juyoung020/trolley-sensor-mount/print/front_jaw.stl

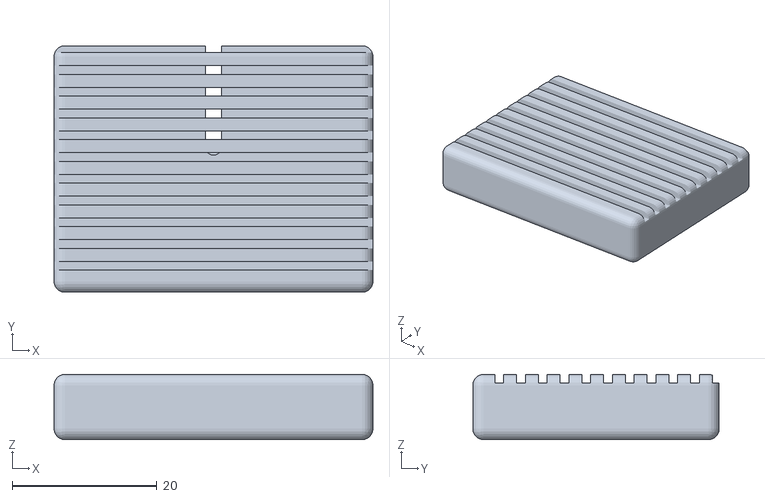
[picture p3: CAD file, 2026-11-08]
print/front_jaw.stl
44.0 x 34.0 x 9.00
