juyoung020/trolley-sensor-mount/print/trolley_mount_X2D.3mf

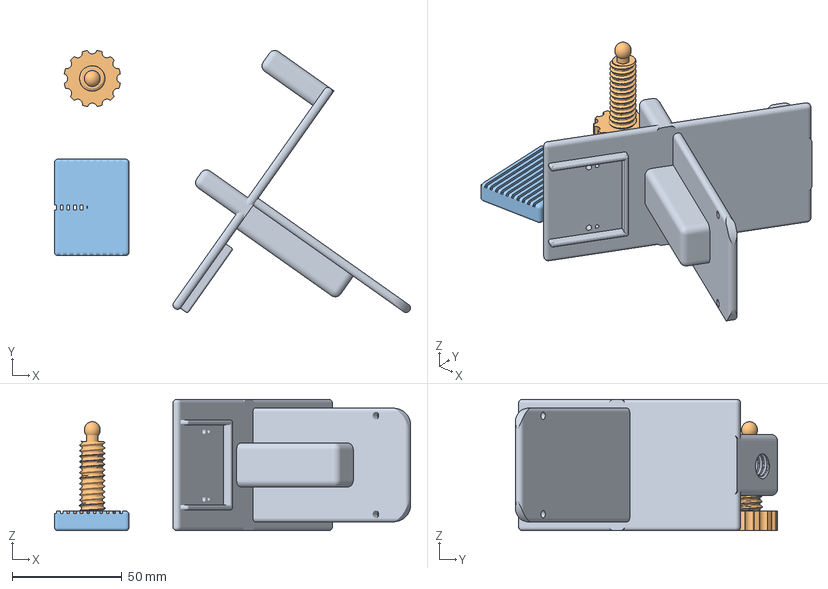
[picture p4: CAD file, 2026-11-08]
print/trolley_mount_X2D.3mf
162.5 x 119.6 x 60.0 mm
mount_body.stl
front_screw.stl
front_jaw.stl
