juyoung020/trolley-sensor-mount/print/mount_body.stl

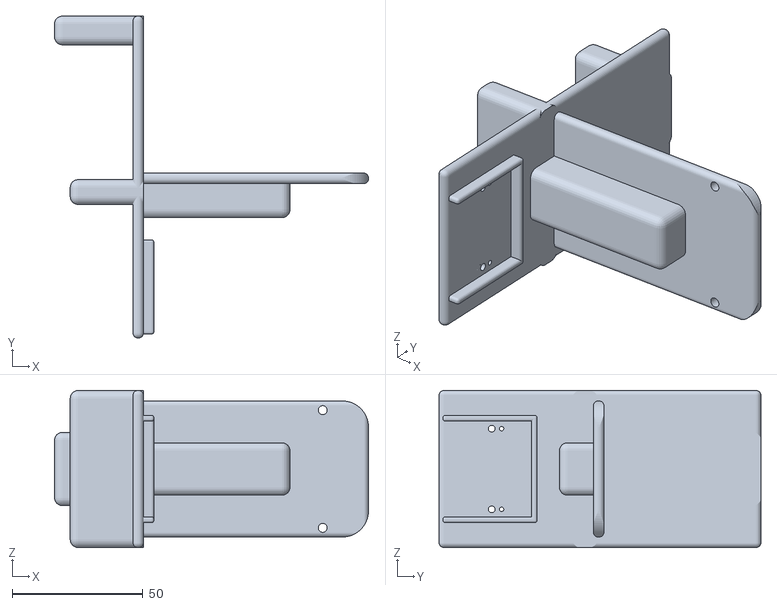
[picture p5: CAD file, 2026-11-08]
print/mount_body.stl
120.0 x 123.0 x 60.0
