juyoung020/trolley-sensor-mount/print/front_screw.stl

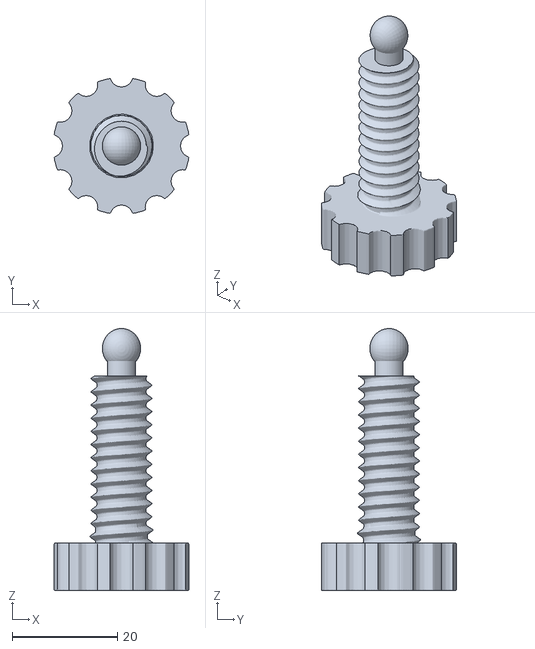
[picture p6: CAD file, 2026-11-08]
print/front_screw.stl
25.6 x 25.6 x 49.8
