juyoung020/trolley-sensor-mount/(list of files, cad)

Other CAD files:
trolley_mount.blend
