juyoung020/trolley-sensor-mount/(commit log)

2026-11-08 Add trolley sensor mount (printable parts, Blender source, images)
    [camera_mast.stl, dowel_1.stl, dowel_2.stl, dowel_3.stl, dowel_4.stl, front_jaw.stl, front_screw.stl, mount_body.stl]
2026-11-08 Replace with one-piece body, filleted outer edges, fixed screw and jaw fit
    [camera_mast.stl, dowel_1.stl, dowel_2.stl, dowel_3.stl, dowel_4.stl, front_jaw.stl, front_screw.stl, mount_body.stl]
2026-11-08 Restore D435 M3 holes in camera plate
    [mount_body.stl]
2026-11-08 Fix screw ball neck, jaw ball socket, D435 and VN-100 hole positions
    [front_jaw.stl, front_screw.stl, mount_body.stl, trolley_mount_X2D.3mf]
2026-11-08 Jaw: slide-in ball slot matched to screw ball center
    [front_jaw.stl, front_screw.stl, trolley_mount_X2D.3mf]
